mgamota2/ECE445_Lab_Dev/README.md

# PCB Design Assignment for Senior Design (ECE 445)

This tutorial: `instructions.pdf` describes how to design and test an STM32 based "dev board", with an on-board H bridge IC to allow for rapid motor control application prototyping.

An example board is found in the `stm32_cad` folder
