mgamota2/ECE445_Lab_Dev/Screenshots/final_board.png

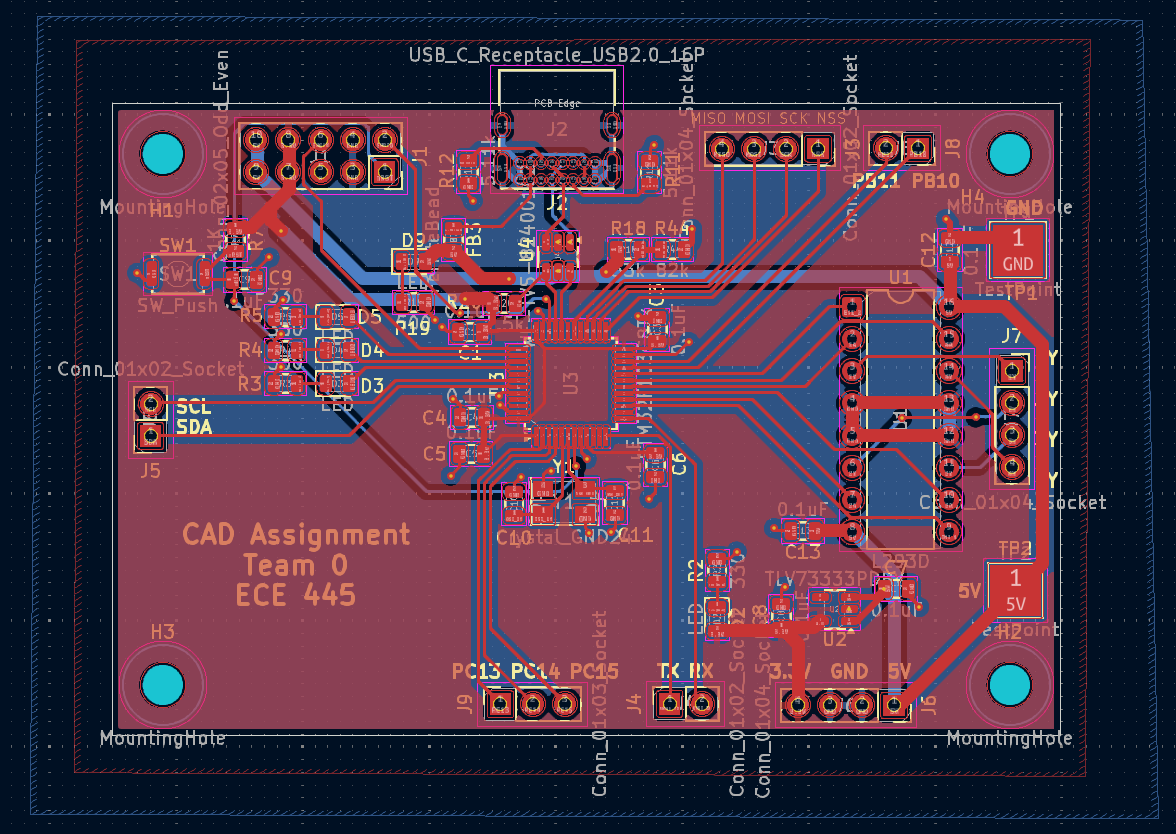
Screenshots/final_board.png
