mgamota2/ECE445_Lab_Dev/Screenshots/track_sizes.png

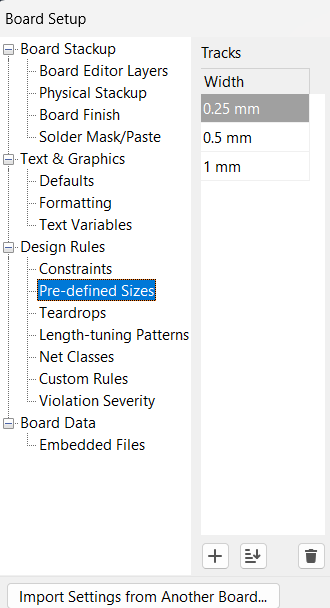
Screenshots/track_sizes.png
