mgamota2/ECE445_Lab_Dev/Digikey_BOM.xlsx

Index | Quantity | Part Number | Manufacturer Part Number | Description | Customer Reference | Available | Backorder | Unit Price | Extended Price USD
1 | 1 | 50-ECS-80-8-30BQ-JES-CT-ND | ECS-80-8-30BQ-JES-TR | CRYSTAL 8.0000MHZ 8PF SMD |  | 1 | 0 | 0.78 | 0.78
2 | 1 | 732-4473-1-ND | 82400102 | TVS DIODE 5VWM 7.7VC SOT23-6L |  | 1 | 0 | 0.86 | 0.86
3 | 1 | 497-6063-ND | STM32F103C8T6 | IC MCU 32BIT 64KB FLASH 48LQFP |  | 1 | 0 | 6.08 | 6.08
4 | 1 | 296-38492-1-ND | TLV73333PDBVT | IC REG LINEAR 3.3V 300MA SOT23-5 |  | 1 | 0 | 0.8 | 0.80
5 | 1 | 497-2936-5-ND | L293D | IC MTRDRV BIPLR 4.5-36V 16PWRDIP |  | 1 | 0 | 7.85 | 7.85
6 | 1 | 2073-USB4085-GF-ACT-ND | USB4085-GF-A | CONN RCPT USB2.0 TYPE C 16+8POS |  | 1 | 0 | 0.88 | 0.88
7 | 5 | 160-1423-1-ND | LTST-C171GKT | LED GREEN CLEAR CHIP SMD |  | 5 | 0 | 0.15 | 0.75
8 | 2 | 399-C0805C100JDGACTUCT-ND | C0805C100JDGACTU | CAP CER 10PF 1KV C0G/NP0 0805 |  | 2 | 0 | 0.39 | 0.78
9 | 10 | 311-1140-1-ND | CC0805KRX7R9BB104 | CAP CER 0.1UF 50V X7R 0805 |  | 10 | 0 | 0.027 | 0.27
10 | 1 | 240-2383-1-ND | LI0805H121R-10 | FERRITE BEAD 120 OHM 0805 1LN |  | 1 | 0 | 0.12 | 0.12
11 | 4 | CR0805-JW-331ELFCT-ND | CR0805-JW-331ELF | RES SMD 330 OHM 5% 1/8W 0805 |  | 4 | 0 | 0.1 | 0.40
12 | 2 | 311-1.5KARCT-ND | RC0805JR-071K5L | RES 1.5K OHM 5% 1/8W 0805 |  | 2 | 0 | 0.1 | 0.20
13 | 1 | 311-499CRCT-ND | RC0805FR-07499RL | RES 499 OHM 1% 1/8W 0805 |  | 1 | 0 | 0.1 | 0.10
14 | 1 | 13-RC0805FR-1333KLCT-ND | RC0805FR-1333KL | RES 33K OHM 1% 1/8W 0805 |  | 1 | 0 | 0.1 | 0.10
15 | 2 | 13-RC0805FR-105K11LCT-ND | RC0805FR-105K11L | RES 5.11K OHM 1% 1/8W 0805 |  | 2 | 0 | 0.1 | 0.20
16 | 1 | 311-82.0KCRCT-ND | RC0805FR-0782KL | RES 82K OHM 1% 1/8W 0805 |  | 1 | 0 | 0.1 | 0.10
