mgamota2/ECE445_Lab_Dev/stm32_cad/stm32_cad.kicad_pcb

## KiCad design stm32_cad/stm32_cad.kicad_pcb (2025-08-24)

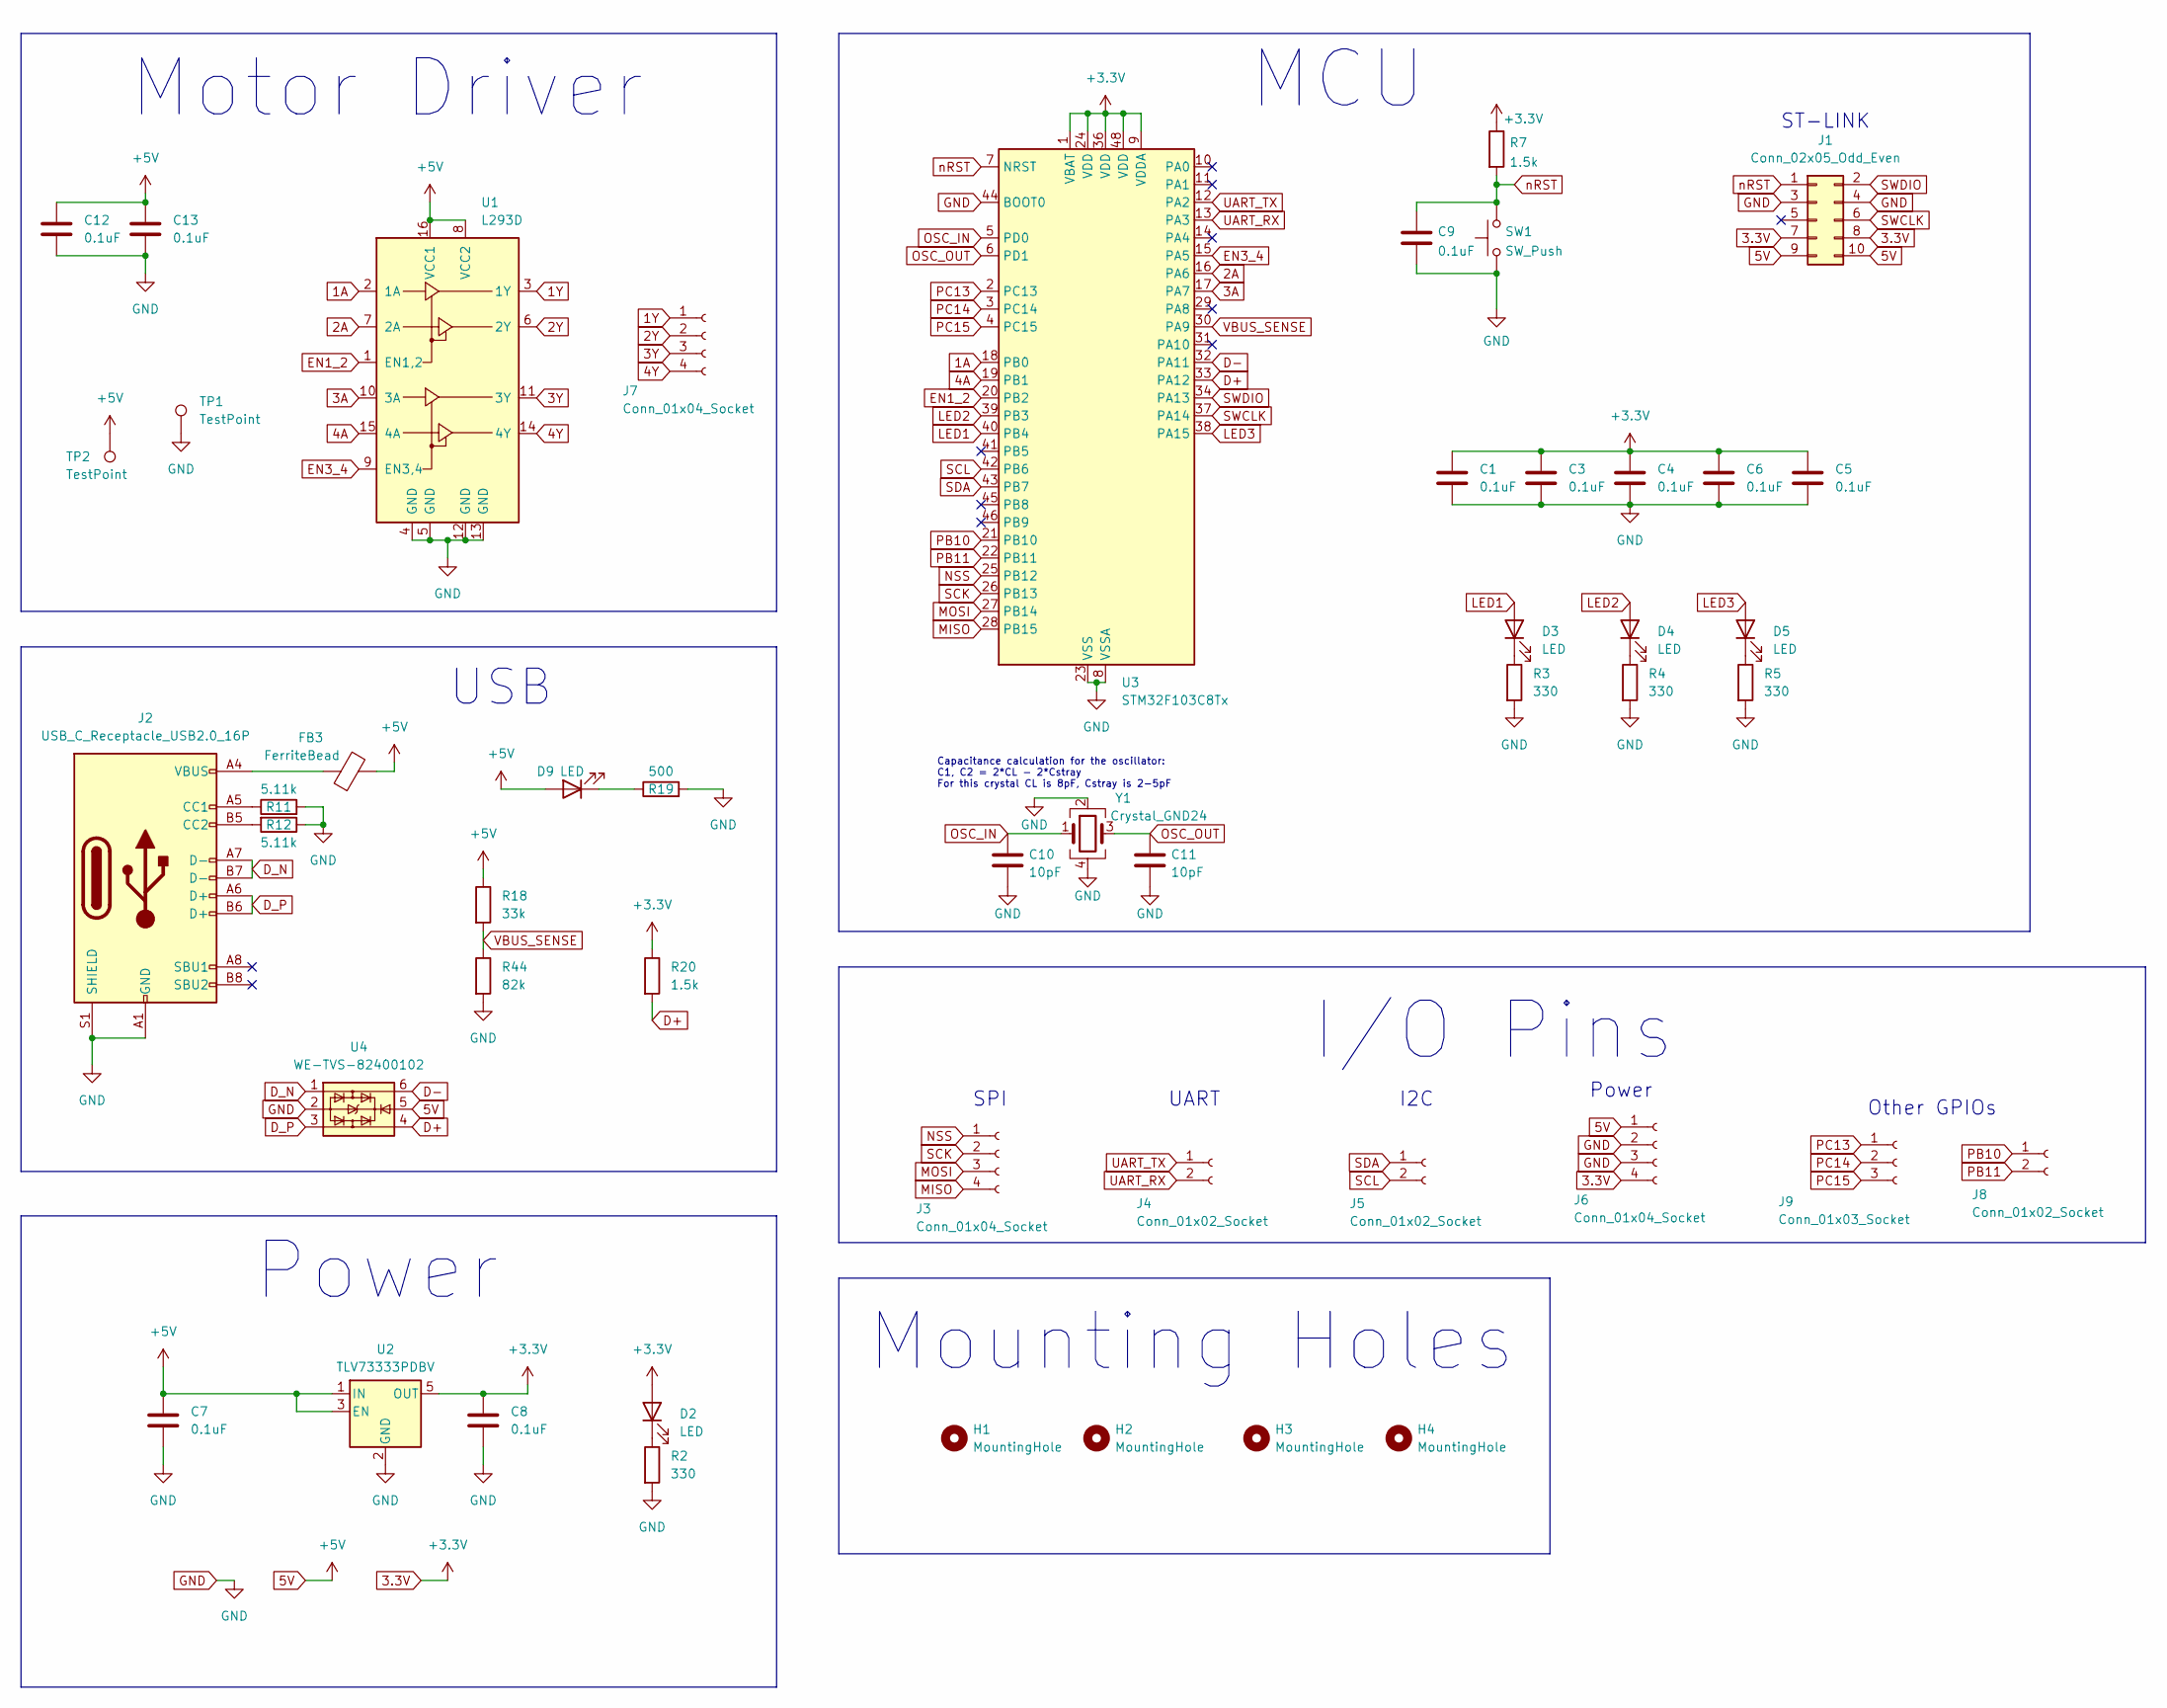
[picture p44: schematic stm32_cad.kicad_sch]

Parts:
C1, C3, C4, C5, C6, C7, C8, C9, C12, C13: 0.1uF; C_0805_2012Metric
C10, C11: 10pF; C_0805_2012Metric
D2, D3, D4, D5, D9: LED; LED_0805_2012Metric
FB3: FerriteBead; R_0805_2012Metric
H1, H2, H3, H4: MountingHole; MountingHole_3.2mm_M3
J1: Conn_02x05_Odd_Even; PinSocket_2x05_P2.54mm_Vertical
J2: USB_C_Receptacle_USB2.0_16P; USB_C_Receptacle_GCT_USB4085
J3, J6, J7: Conn_01x04_Socket; PinSocket_1x04_P2.54mm_Vertical
J4, J5, J8: Conn_01x02_Socket; PinSocket_1x02_P2.54mm_Vertical
J9: Conn_01x03_Socket; PinSocket_1x03_P2.54mm_Vertical
R2, R3, R4, R5: 330; R_0805_2012Metric
R7, R20: 1.5k; R_0805_2012Metric
R11, R12: 5.11k; R_0805_2012Metric
R18: 33k; R_0805_2012Metric
R19: 500; R_0805_2012Metric
R44: 82k; R_0805_2012Metric
SW1: SW_Push; SW_Push_SPST_NO_Alps_SKRK
TP1, TP2: TestPoint; TestPoint_Pad_4.0x4.0mm
U1: L293D; DIP-16_W7.62mm
U2: TLV73333PDBV; SOT-23-5
U3: STM32F103C8Tx; LQFP-48_7x7mm_P0.5mm
U4: WE-TVS-82400102; SOT-23-6
Y1: Crystal_GND24; Crystal_SMD_5032-4Pin_5.0x3.2mm

Connections:
1A: U1.2 (1A), U3.18 (PB0)
1Y: J7.1, U1.3 (1Y)
2A: U1.7 (2A), U3.16 (PA6)
2Y: J7.2, U1.6 (2Y)
3.3V: C1.1, C3.1, C4.1, C5.1, C6.1, C8.1, D2.2 (A), J1.7, J1.8, J6.4, R7.1, R20.1, U2.5 (OUT), U3.1 (VBAT), U3.9 (VDDA), U3.24 (VDD), U3.36 (VDD), U3.48 (VDD)
3A: U1.10 (3A), U3.17 (PA7)
3Y: J7.3, U1.11 (3Y)
4A: U1.15 (4A), U3.19 (PB1)
4Y: J7.4, U1.14 (4Y)
5V: C7.1, C12.1, C13.1, D9.2 (A), FB3.2, J1.9, J1.10, J6.1, R18.1, TP2.1, U1.8 (VCC2), U1.16 (VCC1), U2.1 (IN), U2.3 (EN), U4.5
D+: R20.2, U3.33 (PA12), U4.4
D-: U3.32 (PA11), U4.6
D_N: J2.A7 (D-), J2.B7 (D-), U4.1
D_P: J2.A6 (D+), J2.B6 (D+), U4.3
EN1_2: U1.1 (EN1,2), U3.20 (PB2)
EN3_4: U1.9 (EN3,4), U3.15 (PA5)
GND: C1.2, C3.2, C4.2, C5.2, C6.2, C7.2, C8.2, C9.2, C10.2, C11.2, C12.2, C13.2, J1.3, J1.4, J2.A1 (GND), J2.A12 (GND), J2.B1 (GND), J2.B12 (GND), J2.S1 (SHIELD), J6.2, J6.3, R2.2, R3.2, R4.2, R5.2, R11.2, R12.1, R19.2, R44.2, SW1.1, TP1.1, U1.4 (GND), U1.5 (GND), U1.12 (GND), U1.13 (GND), U2.2 (GND), U3.8 (VSSA), U3.23 (VSS), U3.35 (VSS), U3.44 (BOOT0), U3.47 (VSS), U4.2, Y1.2, Y1.4
LED1: D3.2 (A), U3.40 (PB4)
LED2: D4.2 (A), U3.39 (PB3)
LED3: D5.2 (A), U3.38 (PA15)
MISO: J3.4, U3.28 (PB15)
MOSI: J3.3, U3.27 (PB14)
NSS: J3.1, U3.25 (PB12)
unnamed: D2.1 (K), R2.1
unnamed: D3.1 (K), R3.1
unnamed: D4.1 (K), R4.1
unnamed: D5.1 (K), R5.1
unnamed: D9.1 (K), R19.1
unnamed: FB3.1, J2.A4 (VBUS), J2.A9 (VBUS), J2.B4 (VBUS), J2.B9 (VBUS)
unnamed: J2.A5 (CC1), R11.1
unnamed: J2.B5 (CC2), R12.2
OSC_IN: C10.1, U3.5 (PD0), Y1.1
OSC_OUT: C11.1, U3.6 (PD1), Y1.3
PB10: J8.1, U3.21 (PB10)
PB11: J8.2, U3.22 (PB11)
PC13: J9.1, U3.2 (PC13)
PC14: J9.2, U3.3 (PC14)
PC15: J9.3, U3.4 (PC15)
SCK: J3.2, U3.26 (PB13)
SCL: J5.2, U3.42 (PB6)
SDA: J5.1, U3.43 (PB7)
SWCLK: J1.6, U3.37 (PA14)
SWDIO: J1.2, U3.34 (PA13)
UART_RX: J4.2, U3.13 (PA3)
UART_TX: J4.1, U3.12 (PA2)
VBUS_SENSE: R18.2, R44.1, U3.30 (PA9)
nRST: C9.1, J1.1, R7.2, SW1.2, U3.7 (NRST)

Notes on the sheet:
MCU
SPI
Motor Driver
I2C
I/O Pins
Power
Capacitance calculation for the oscillator: C1, C2 = 2*CL - 2*Cstray For this crystal CL is 8pF, Cstray is 2-5pF
Power
USB
UART
Other GPIOs
ST-LINK
Mounting Holes

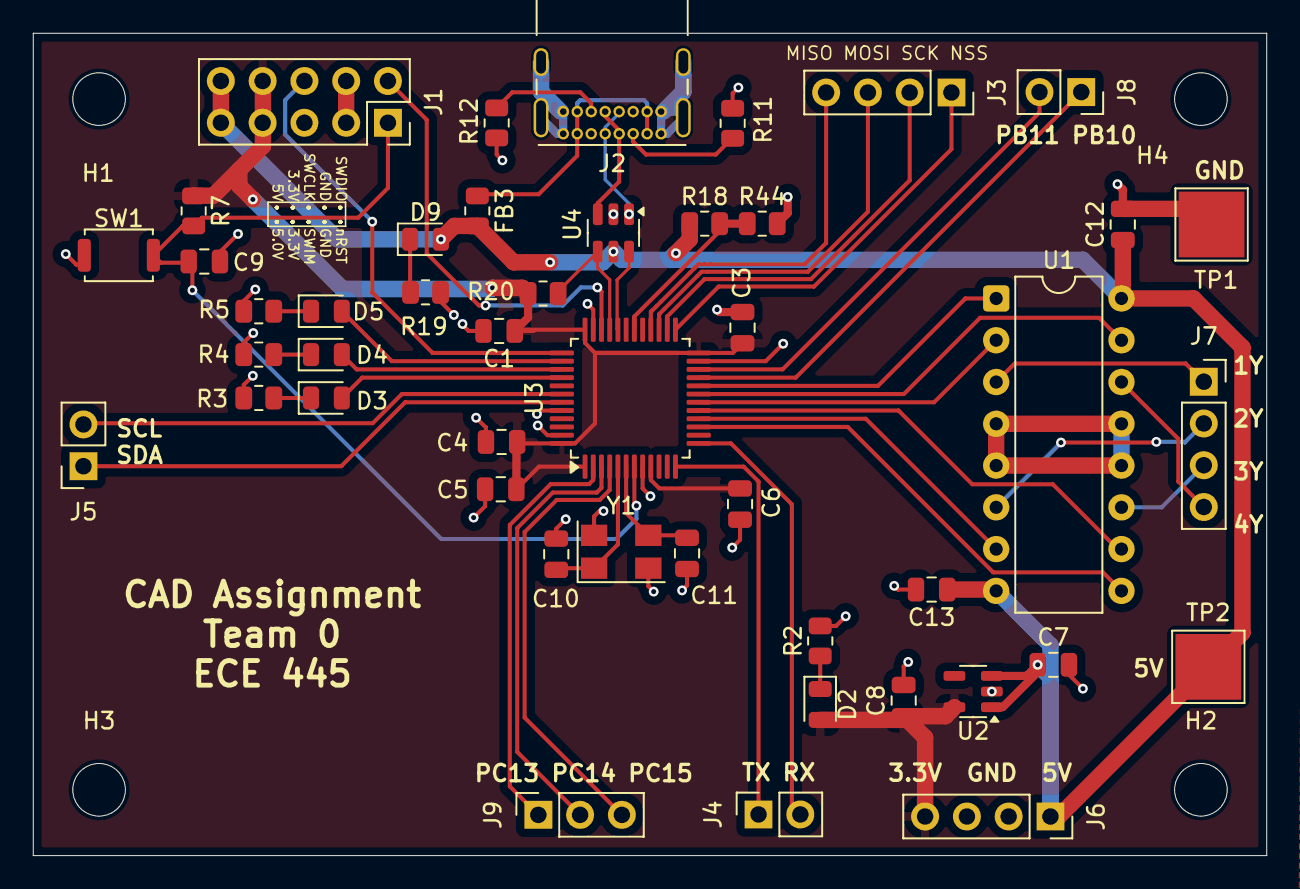
[picture p45: board stm32_cad.kicad_pcb from above]

Board: 2 copper layers, 75.0 x 50.0 mm, 50 parts (0 on the bottom side), 47 nets.
